AirframeStore/OpenBeacon/kicad/OB3k_v01_261112/OB3k_v01_261112.kicad_pcb

## KiCad design kicad/OB3k_v01_261112/OB3k_v01_261112.kicad_pcb (2026-11-12)

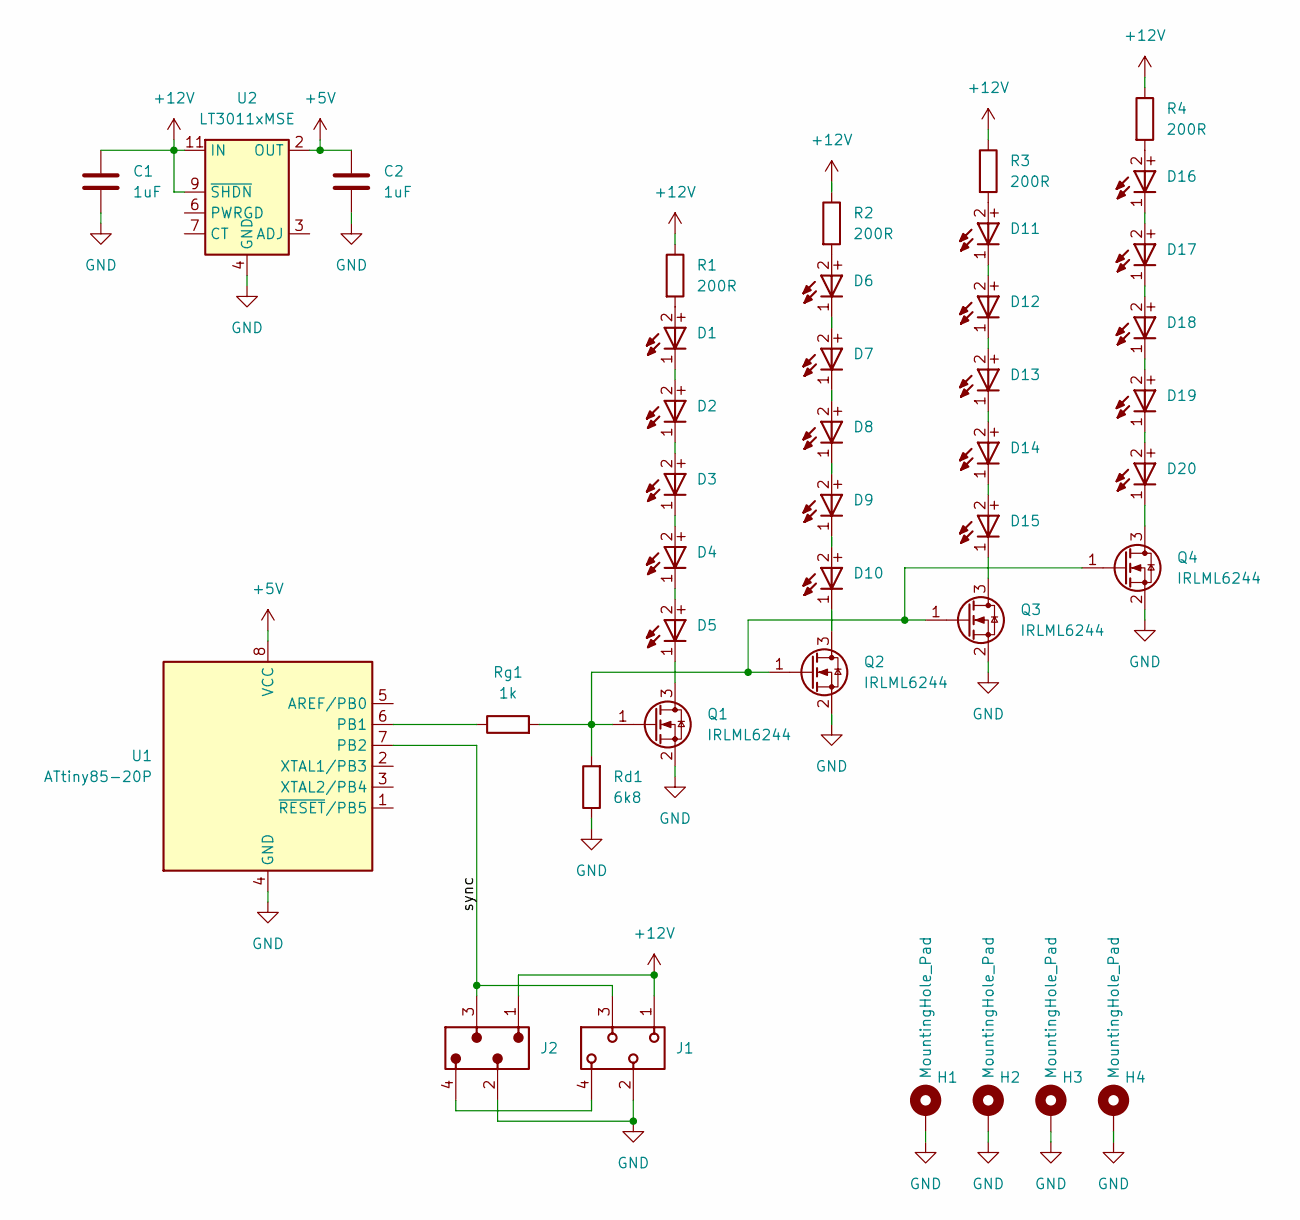
[picture p3: schematic OB3k_v01_261112.kicad_sch, OpenBeacon]

Parts:
C1, C2: 1uF; C_1206_3216Metric_Pad1.33x1.80mm_HandSolder
D1, D2, D3, D4, D5, D6, D7, D8, D9, D10, D11, D12, D13, D14, D15, D16, D17, D18, D19, D20: 1204_155124RS73200; D_Wurth_WL-SMSW-1204; Part Number 155124RS73200
H1: MountingHole_Pad
H2, H3, H4: MountingHole_Pad; MountingHole_3.2mm_M3_Pad_TopBottom
J1: 690367180472; J_Wurth_WR-MM_690367180472; Working Voltage (V (AC)) 250
J2: 690357100472; J_Wurth_WR-MM_690357100472
Q1, Q2, Q3, Q4: IRLML6244; SOT-23
R1, R2, R3, R4: 200R; R_0805_2012Metric
Rd1: 6k8; R_0805_2012Metric
Rg1: 1k; R_0805_2012Metric
U1: ATtiny85-20P; DIP-8_W7.62mm
U2: LT3011xMSE; MSOP-12-1EP_3x4.039mm_P0.65mm_EP1.651x2.845mm

Connections:
+5V: C2.1, U1.8 (VCC), U2.2 (OUT)
+12V: C1.1, J1.1, J2.1, R1.1, R2.1, R3.1, R4.1, U2.9 (~SHDN), U2.11 (IN)
/sync: J1.3, J2.3, U1.7 (PB2)
GND: C1.2, C2.2, H1.1 (1_1), H2.1 (1_1), H3.1 (1_1), H4.1 (1_1), J1.2, J2.2, Q1.2 (S), Q2.2 (S), Q3.2 (S), Q4.2 (S), Rd1.1, U1.4 (GND), U2.4 (GND), U2.13 (GND)
unnamed: D1.2 (+), R1.2
unnamed: D1.1 (-), D2.2 (+)
unnamed: D2.1 (-), D3.2 (+)
unnamed: D3.1 (-), D4.2 (+)
unnamed: D4.1 (-), D5.2 (+)
unnamed: D5.1 (-), Q1.3 (D)
unnamed: D6.2 (+), R2.2
unnamed: D6.1 (-), D7.2 (+)
unnamed: D7.1 (-), D8.2 (+)
unnamed: D8.1 (-), D9.2 (+)
unnamed: D9.1 (-), D10.2 (+)
unnamed: D10.1 (-), Q2.3 (D)
unnamed: D11.2 (+), R3.2
unnamed: D11.1 (-), D12.2 (+)
unnamed: D12.1 (-), D13.2 (+)
unnamed: D13.1 (-), D14.2 (+)
unnamed: D14.1 (-), D15.2 (+)
unnamed: D15.1 (-), Q3.3 (D)
unnamed: D16.2 (+), R4.2
unnamed: D16.1 (-), D17.2 (+)
unnamed: D17.1 (-), D18.2 (+)
unnamed: D18.1 (-), D19.2 (+)
unnamed: D19.1 (-), D20.2 (+)
unnamed: D20.1 (-), Q4.3 (D)
unnamed: J1.4, J2.4
unnamed: Q1.1 (G), Q2.1 (G), Q3.1 (G), Q4.1 (G), Rd1.2, Rg1.2
unnamed: Rg1.1, U1.6 (PB1)

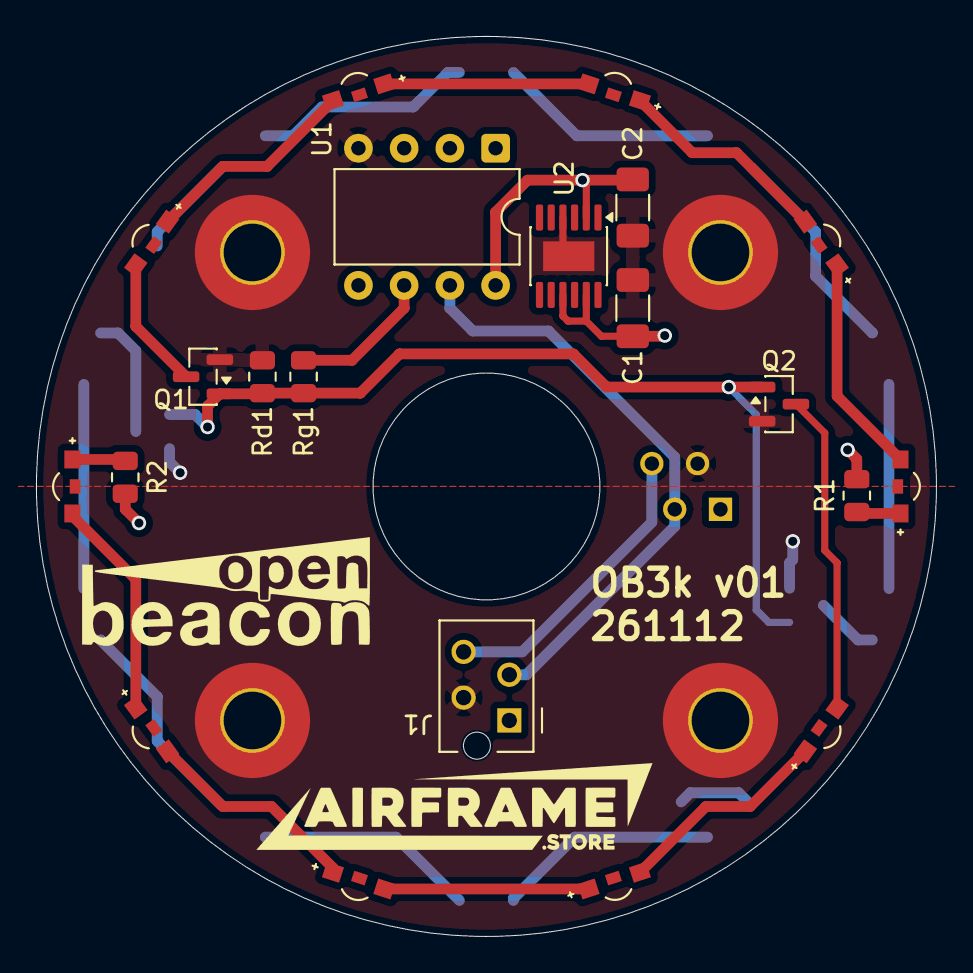
[picture p4: board OB3k_v01_261112.kicad_pcb from above]

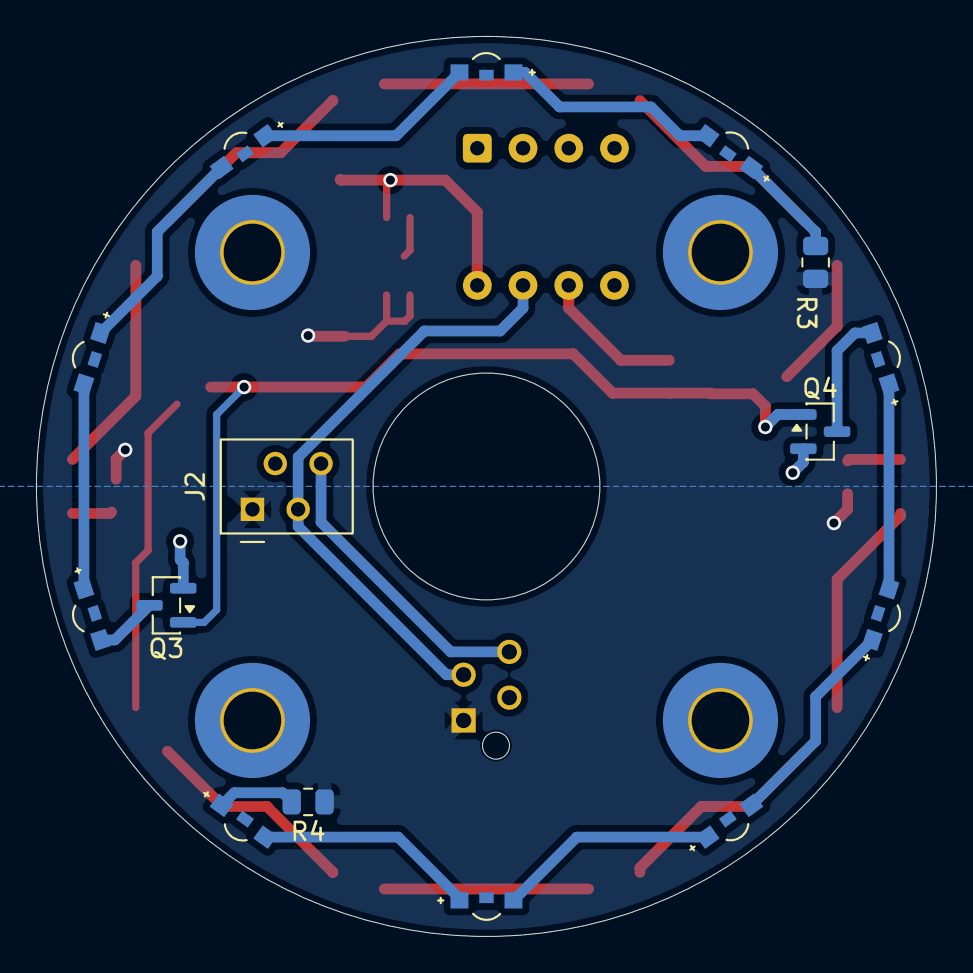
[picture p5: board OB3k_v01_261112.kicad_pcb from below]

Board: 2 copper layers, 50.0 x 50.0 mm, 40 parts (15 on the bottom side), 31 nets.
