AirframeStore/OpenBeacon/(commit log)

2026-11-12 added OB3k v01 kicad files
    [OB3k_v01_261112.kicad_pcb, OB3k_v01_261112.kicad_sch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]
2026-11-12 shortened beacon on time to 750ms
    [OpenBeacon_Arduino_001.ino]
